romi2002/RS232USBHost/USBHostRS232.kicad_pcb

## KiCad design USBHostRS232.kicad_pcb (2021-04-07)

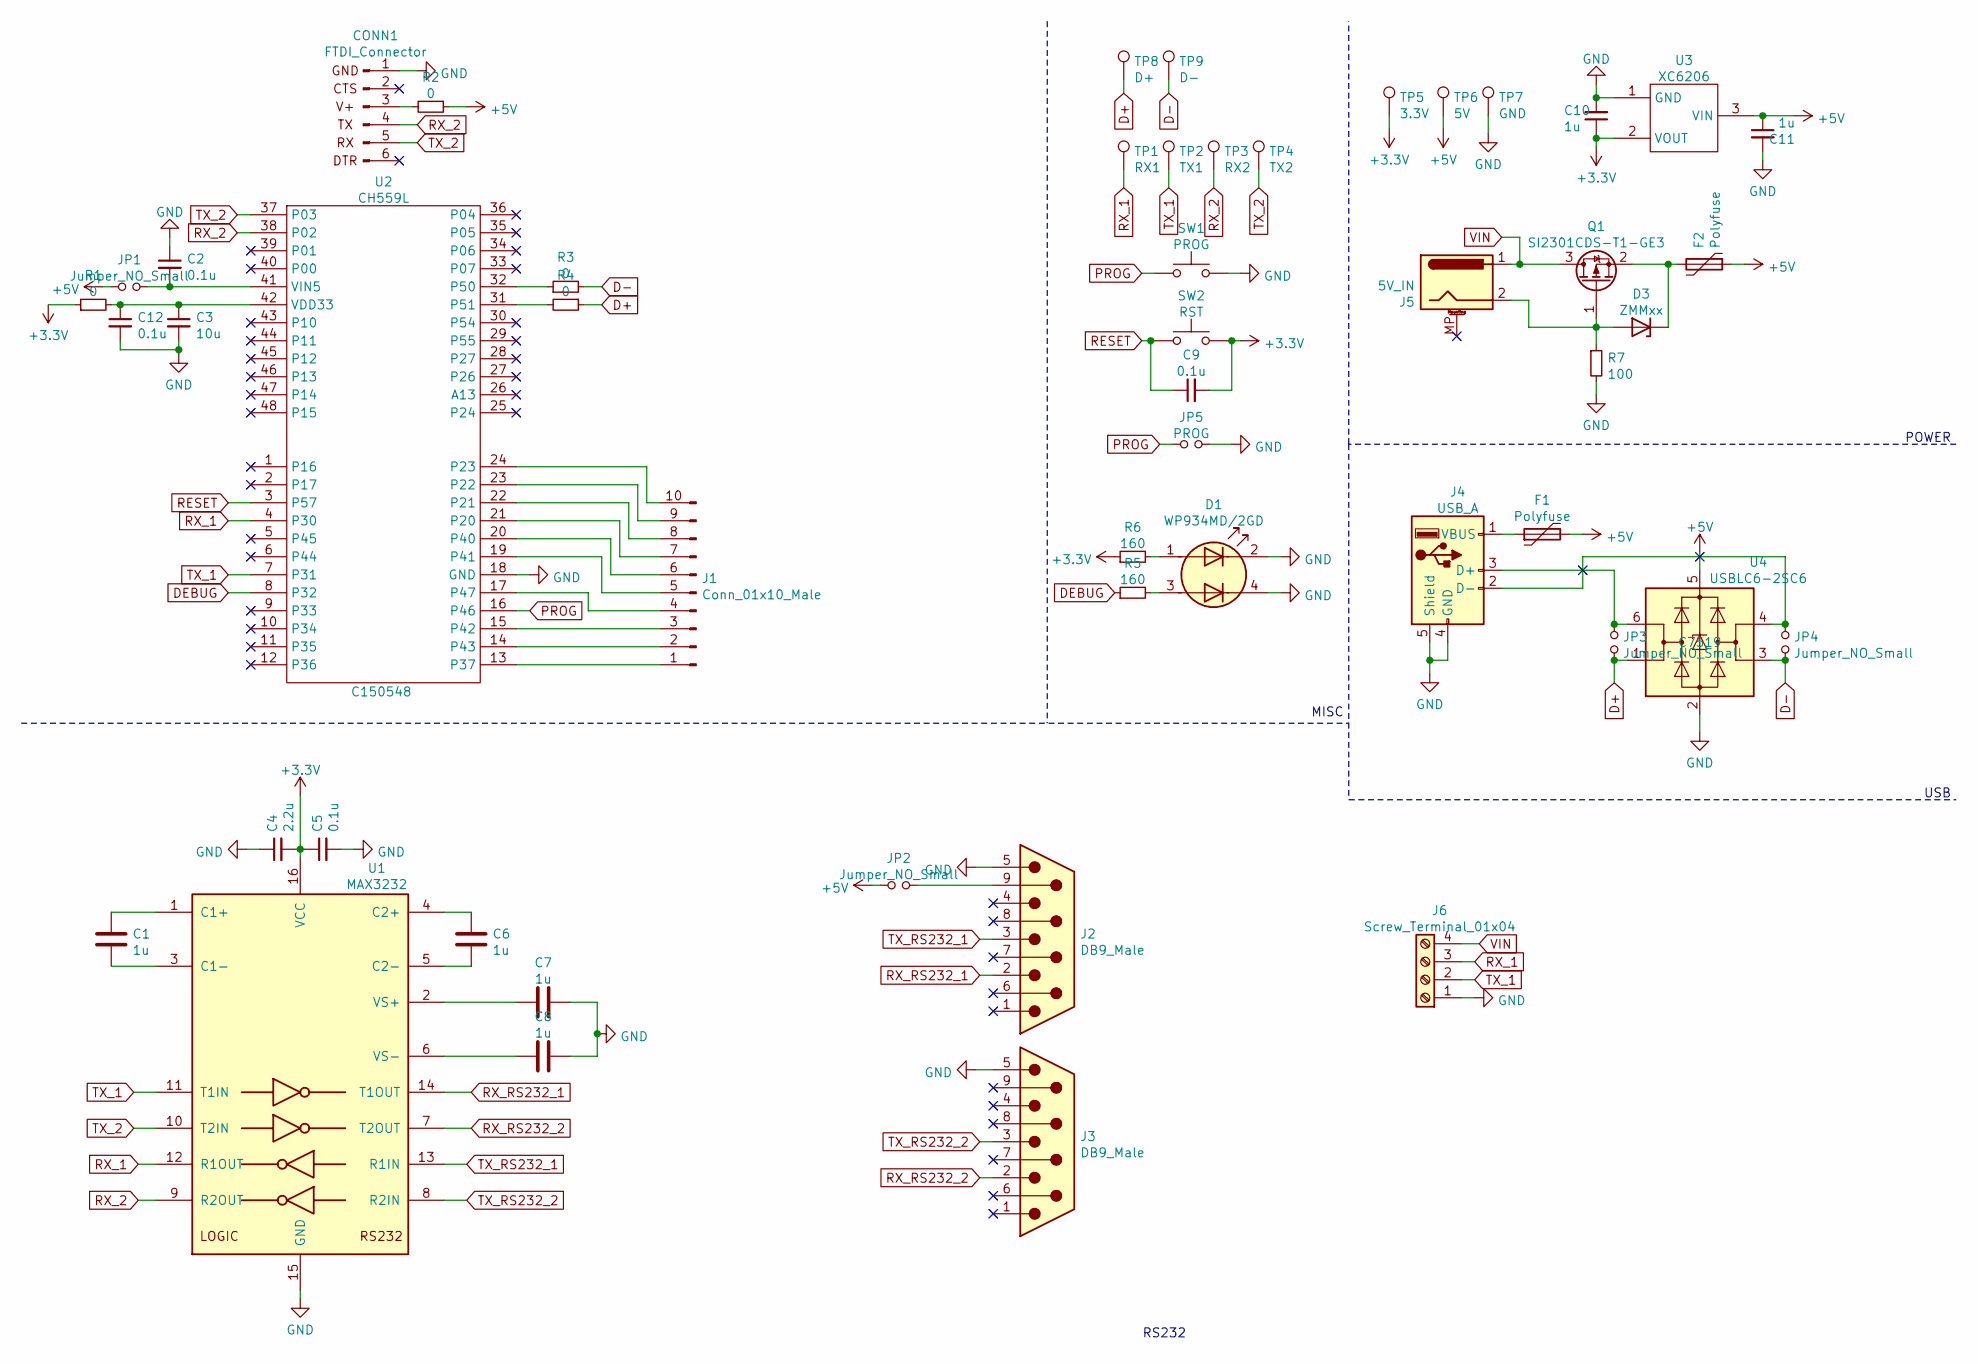
[picture p1: schematic USBHostRS232.kicad_sch, USBHost RS232]

Parts:
C1, C6, C7, C8, C10, C11: 1u; C_0603_1608Metric; LCSC C15849
C2, C5, C9, C12: 0.1u; C_0603_1608Metric; LCSC C14663
C3: 10u; C_0603_1608Metric; LCSC C23630
C4: 2.2u; C_0603_1608Metric; LCSC C23630
CONN1: FTDI_Connector; PinSocket_1x06_P2.54mm_Vertical
D1: WP934MD/2GD; 2GD; DigiKey WP934MD/2GD
D3: ZMMxx; D_MiniMELF; LCSC C8062
F1, F2: Polyfuse; Fuse_1812_4532Metric; LCSC C20810
J1: Conn_01x10_Male; PinSocket_1x10_P2.54mm_Vertical
J2, J3: DB9_Male; DSUB-9_Male_Horizontal_P2.77x2.84mm_EdgePinOffset9.40mm; LCSC C75750
J4: USB_A; USB_A_Molex_67643_Horizontal
J5: 5V_IN; BarrelJack_CUI_PJ-063AH_Horizontal
J6: Screw_Terminal_01x04; TerminalBlock_Phoenix_MKDS-1,5-4-5.08_1x04_P5.08mm_Horizont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
JP1, JP2, JP3, JP4: Jumper_NO_Small; SolderJumper-2_P1.3mm_Open_RoundedPad1.0x1.5mm
JP5: PROG; PinSocket_1x02_P2.54mm_Vertical
Q1: SI2301CDS-T1-GE3; SOT-23; LCSC C10487
R1, R2, R3, R4: 0; R_0603_1608Metric; LCSC C23193
R5, R6: 160; R_0603_1608Metric; LCSC C22818
R7: 100; R_0603_1608Metric; LCSC C22775
SW1: PROG; SW_SPST_EVQP2
SW2: RST; SW_SPST_EVQP2
TP1: RX1; TestPoint_Pad_D2.5mm
TP2: TX1; TestPoint_Pad_D2.5mm
TP3: RX2; TestPoint_Pad_D2.5mm
TP4: TX2; TestPoint_Pad_D2.5mm
TP5: 3.3V; TestPoint_Loop_D2.60mm_Drill1.4mm_Beaded
TP6: 5V; TestPoint_Loop_D2.60mm_Drill1.4mm_Beaded
TP7: GND; TestPoint_Loop_D2.60mm_Drill1.4mm_Beaded
TP8: D+; TestPoint_Pad_D2.5mm
TP9: D-; TestPoint_Pad_D2.5mm
U1: MAX3232; SOIC-16_3.9x9.9mm_P1.27mm; LCSC C15846
U2: CH559L; LQFP-48_7x7mm_P0.5mm; LCSC C150548
U3: XC6206; SOT-23W; LCSC C5446
U4: USBLC6-2SC6; SOT-23-6; LCSC C7519

Connections:
+3V3: C4.2, C5.1, C9.2, C10.1, R1.1, R6.1, SW2.2, TP5.1, U1.16 (VCC), U3.2 (VOUT)
+5V: C11.1, F1.2, F2.1, JP1.1, JP2.1, R2.1, TP6.1, U3.3 (VIN), U4.5 (VBUS)
D+: JP3.2, R4.1, TP8.1, U4.1 (I/O1)
D-: JP4.2, R3.2, TP9.1, U4.3 (I/O2)
DEBUG: R5.1, U2.8 (P32)
GND: C2.1, C3.2, C4.1, C5.2, C7.2, C8.2, C10.2, C11.2, C12.2, CONN1.1 (GND), D1.2 (K1), D1.4 (K2), J2.5, J3.5, J4.4 (GND), J4.5 (Shield), J6.1, JP5.2, R7.2, SW1.2, TP7.1, U1.15 (GND), U2.18 (GND), U3.1 (GND), U4.2 (GND)
unnamed: C1.1, U1.1 (C1+)
unnamed: C1.2, U1.3 (C1-)
unnamed: C2.2, JP1.2, U2.41 (VIN5)
unnamed: C6.1, U1.4 (C2+)
unnamed: C6.2, U1.5 (C2-)
unnamed: C7.1, U1.2 (VS+)
unnamed: C8.1, U1.6 (VS-)
unnamed: C3.1, C12.1, R1.2, U2.42 (VDD33)
unnamed: CONN1.3 (5V), R2.2
unnamed: D1.1 (A1), R6.2
unnamed: D1.3 (A2), R5.2
unnamed: D3.1 (K), F2.2, Q1.2 (S)
unnamed: D3.2 (A), J5.2, Q1.1 (G), R7.1
unnamed: F1.1, J4.1 (VBUS)
unnamed: J1.1, U2.13 (P37)
unnamed: J1.2, U2.14 (P43)
unnamed: J1.3, U2.15 (P42)
unnamed: J1.4, U2.17 (P47)
unnamed: J1.5, U2.19 (P41)
unnamed: J1.6, U2.20 (P40)
unnamed: J1.7, U2.21 (P20)
unnamed: J1.8, U2.22 (P21)
unnamed: J1.9, U2.23 (P22)
unnamed: J1.10, U2.24 (P23)
unnamed: J2.9, JP2.2
unnamed: J4.2 (D-), JP4.1, U4.4 (I/O2)
unnamed: J4.3 (D+), JP3.1, U4.6 (I/O1)
unnamed: R3.1, U2.32 (P50)
unnamed: R4.2, U2.31 (P51)
PROG: JP5.1, SW1.1, U2.16 (P46)
RESET: C9.1, SW2.1, U2.3 (P57)
RX_1: J6.3, TP1.1, U1.12 (R1OUT), U2.4 (P30)
RX_2: CONN1.4 (TX), TP3.1, U1.9 (R2OUT), U2.38 (P02)
RX_RS232_1: J2.2, U1.14 (T1OUT)
RX_RS232_2: J3.2, U1.7 (T2OUT)
TX_1: J6.2, TP2.1, U1.11 (T1IN), U2.7 (P31)
TX_2: CONN1.5 (RX), TP4.1, U1.10 (T2IN), U2.37 (P03)
TX_RS232_1: J2.3, U1.13 (R1IN)
TX_RS232_2: J3.3, U1.8 (R2IN)
VIN: J5.1, J6.4, Q1.3 (D)

Notes on the sheet:
RS232
MISC
POWER
USB

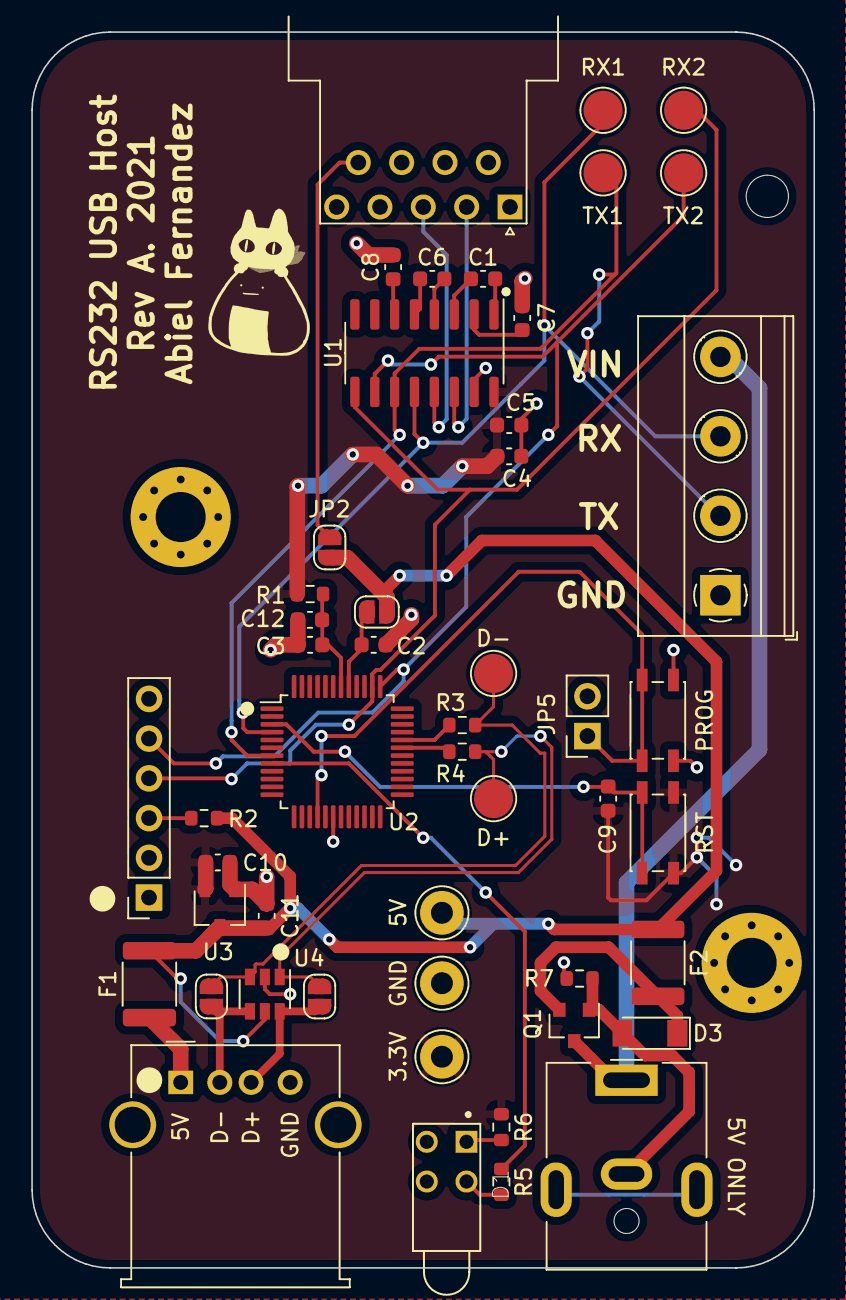
[picture p2: board USBHostRS232.kicad_pcb from above]

Board: 2 copper layers, 50.0 x 79.0 mm, 49 parts (0 on the bottom side), 34 nets.
